yunqingjia/AE-3531-Files/README.md

# AE-3531-Files
Class project for the controls analysis course at Georgia Tech.
