yunqingjia/AE-3531-Files/ControlsProjectStudentTimeline.pdf

### Controls Project Timeline

10/23/18 | Distribute project kits
10/30/18 | Checkpoint 1: Complete PCB and mechanical structure assembly
11/06/18 | Checkpoint 2: Pass Sensor and Serial Plot tests
| Distribute motors and ESCs
11/08/18 | Checkpoint3: Pass ESC and controller tests
11/15/18 | Demo day
11/22/18 | Report due
