yunqingjia/AE-3531-Files/3D Print Files/Dual Motor/Rotating Base.STL

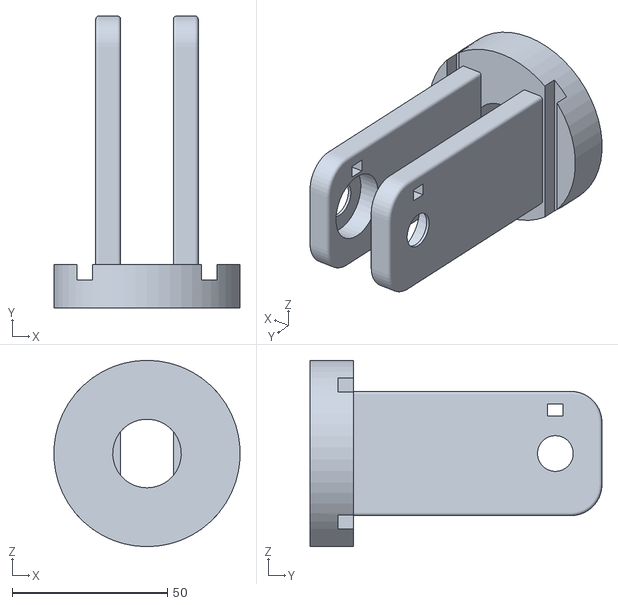
[picture p1: CAD file, 2018-10-11]
3D Print Files/Dual Motor/Rotating Base.STL
59.9 x 94.0 x 60.0
