yunqingjia/AE-3531-Files/3D Print Files/Final Parts for Students/Shaft.STL

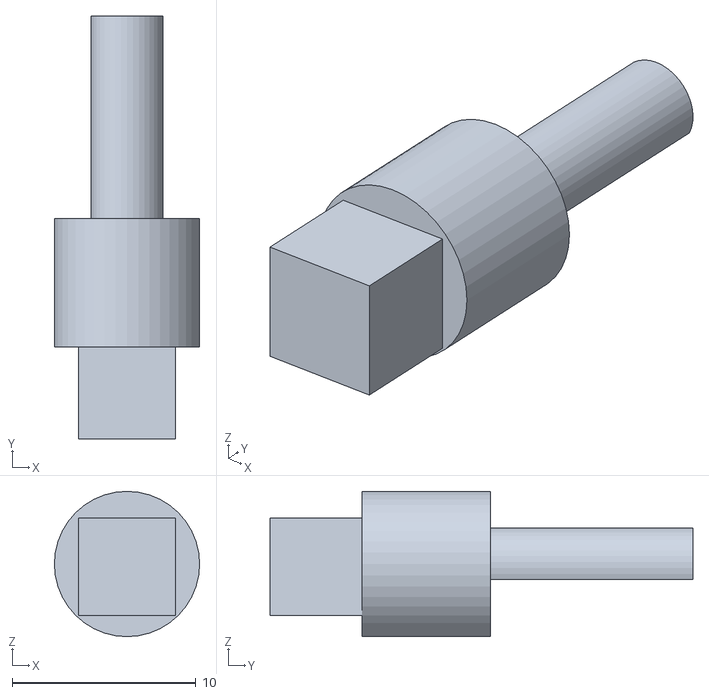
[picture p2: CAD file, 2018-10-11]
3D Print Files/Final Parts for Students/Shaft.STL
7.90 x 23.0 x 7.90
