yunqingjia/AE-3531-Files/3D Print Files/Misc/Fixed Base V2.STL

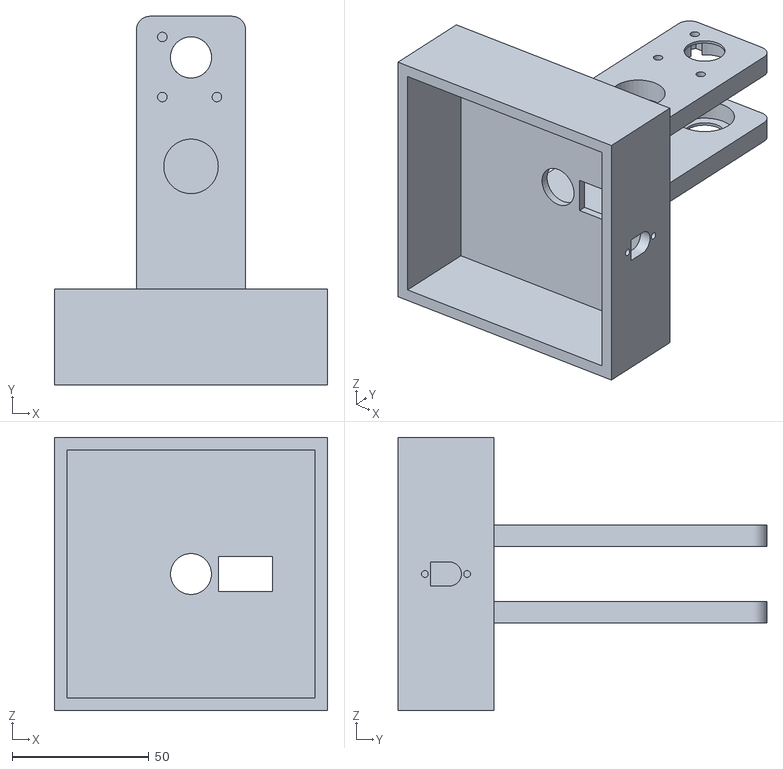
[picture p3: CAD file, 2018-10-11]
3D Print Files/Misc/Fixed Base V2.STL
100.0 x 135.0 x 100.0
