yunqingjia/AE-3531-Files/3D Print Files/Teensy Configuration/Shaft 5.3.STL

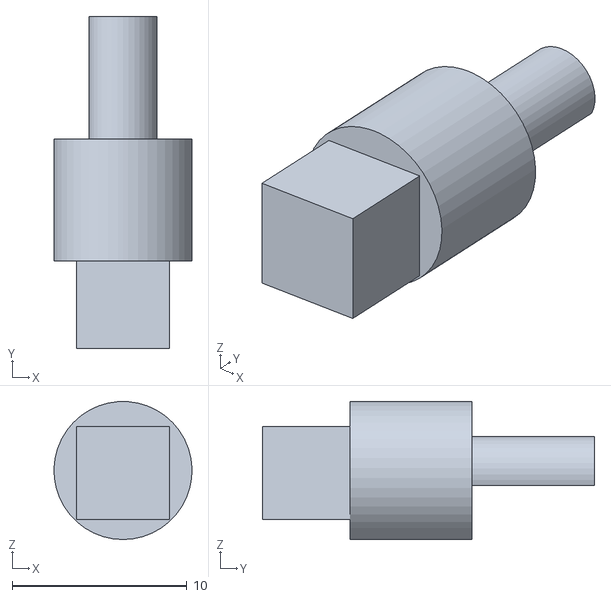
[picture p4: CAD file, 2018-10-11]
3D Print Files/Teensy Configuration/Shaft 5.3.STL
7.89 x 19.0 x 7.90
