yunqingjia/AE-3531-Files/3D Print Files/Dual Motor/Base.STL

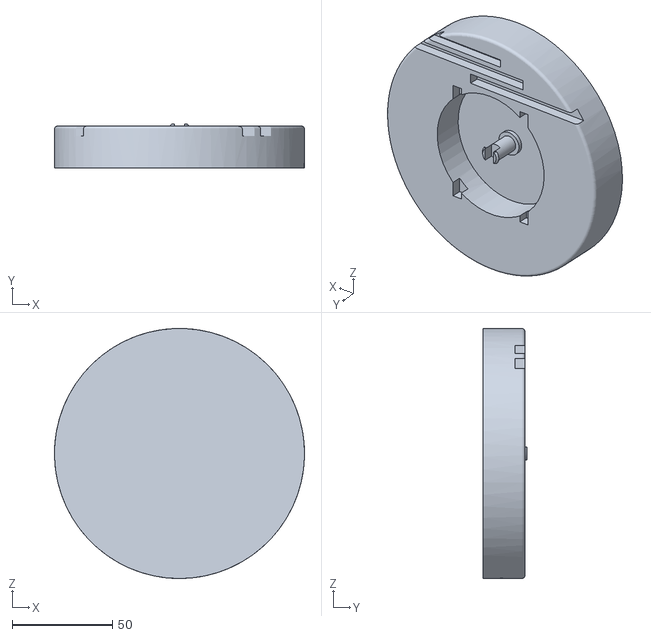
[picture p5: CAD file, 2018-10-11]
3D Print Files/Dual Motor/Base.STL
125.0 x 22.0 x 125.0
