yunqingjia/AE-3531-Files/3D Print Files/Final Parts for Students/Tower.STL

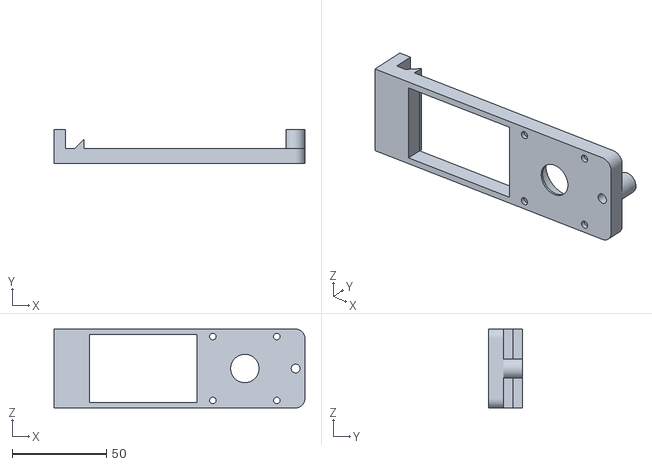
[picture p6: CAD file, 2018-10-11]
3D Print Files/Final Parts for Students/Tower.STL
133.5 x 18.0 x 42.0
