yunqingjia/AE-3531-Files/3D Print Files/Misc/Single Motor Mount.STL

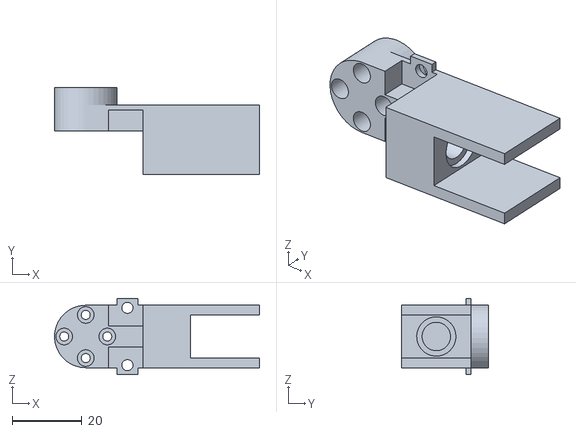
[picture p7: CAD file, 2018-10-11]
3D Print Files/Misc/Single Motor Mount.STL
59.0 x 25.0 x 22.0
