yunqingjia/AE-3531-Files/3D Print Files/Teensy Configuration/FinalBase9.0.STL

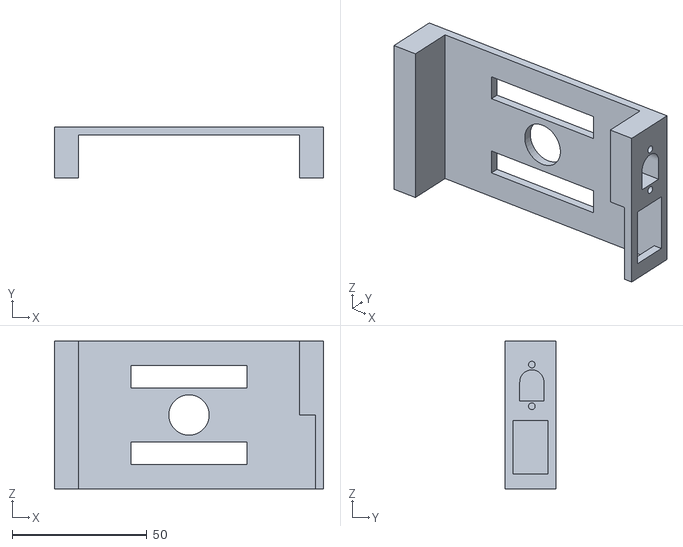
[picture p8: CAD file, 2018-10-11]
3D Print Files/Teensy Configuration/FinalBase9.0.STL
100.0 x 19.0 x 55.0
