yunqingjia/AE-3531-Files/3D Print Files/Dual Motor/Dual Motor Mount.STL

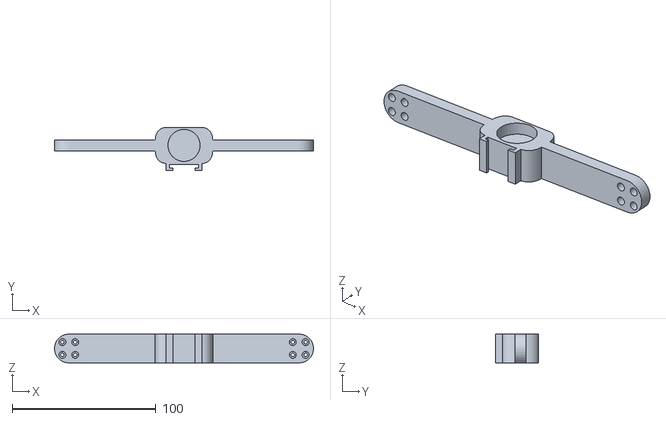
[picture p9: CAD file, 2018-10-11]
3D Print Files/Dual Motor/Dual Motor Mount.STL
179.9 x 30.0 x 20.0
