yunqingjia/AE-3531-Files/3D Print Files/Final Parts for Students/Arm.STL

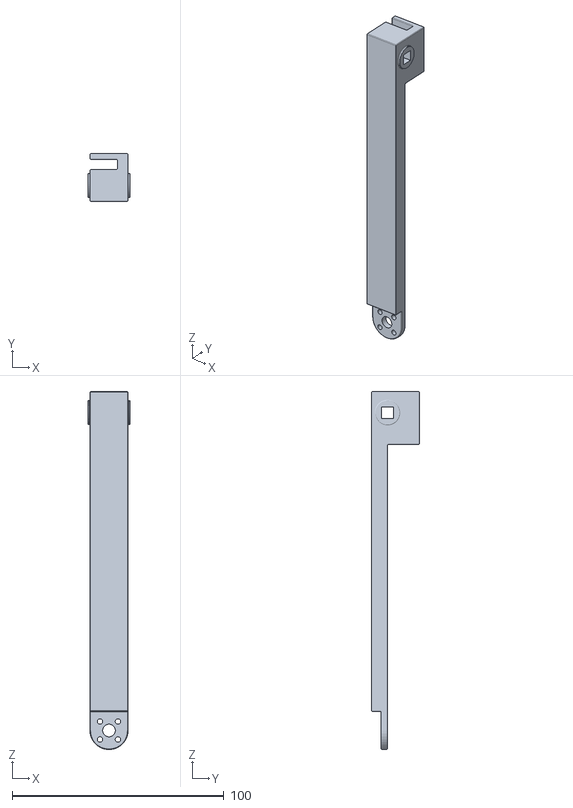
[picture p10: CAD file, 2018-10-11]
3D Print Files/Final Parts for Students/Arm.STL
20.0 x 22.5 x 169.0
