yunqingjia/AE-3531-Files/3D Print Files/Dual Motor/Roll Lock.STL

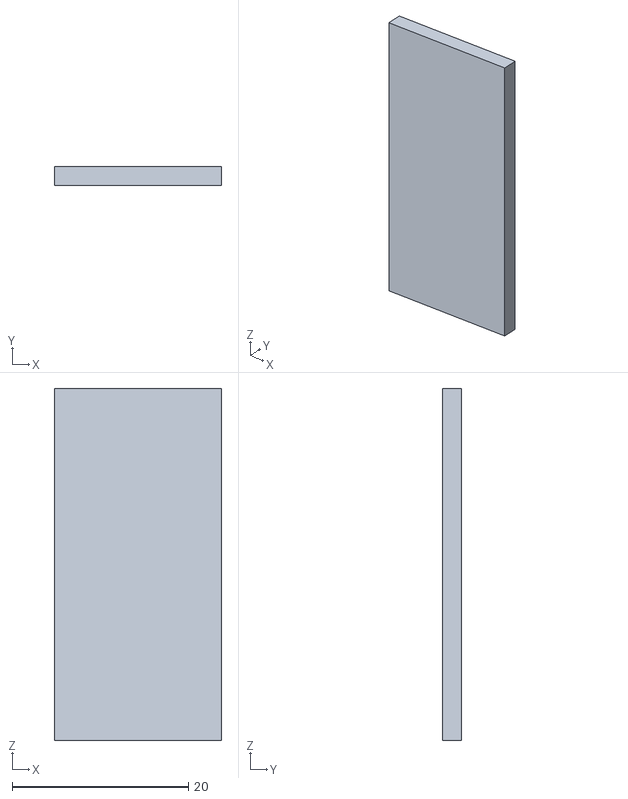
[picture p11: CAD file, 2018-10-11]
3D Print Files/Dual Motor/Roll Lock.STL
19.0 x 2.20 x 40.0
