yunqingjia/AE-3531-Files/3D Print Files/Teensy Configuration/Shaft.STL

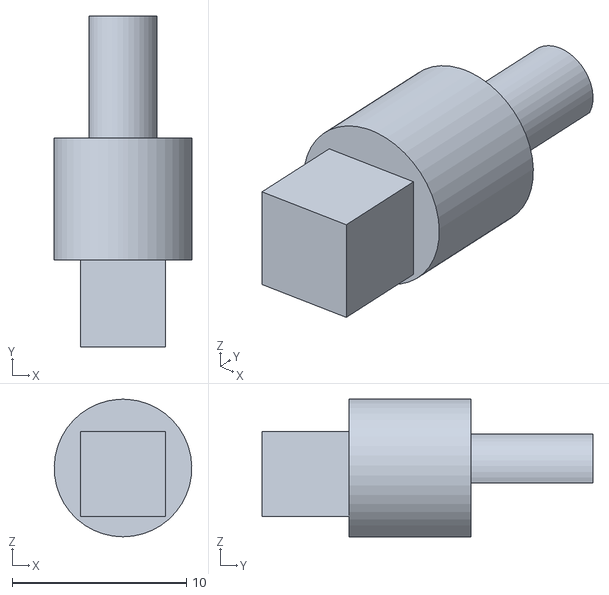
[picture p12: CAD file, 2018-10-11]
3D Print Files/Teensy Configuration/Shaft.STL
7.89 x 19.0 x 7.90
