yunqingjia/AE-3531-Files/3D Print Files/Teensy Configuration/Shaft 5.4 8.0.STL

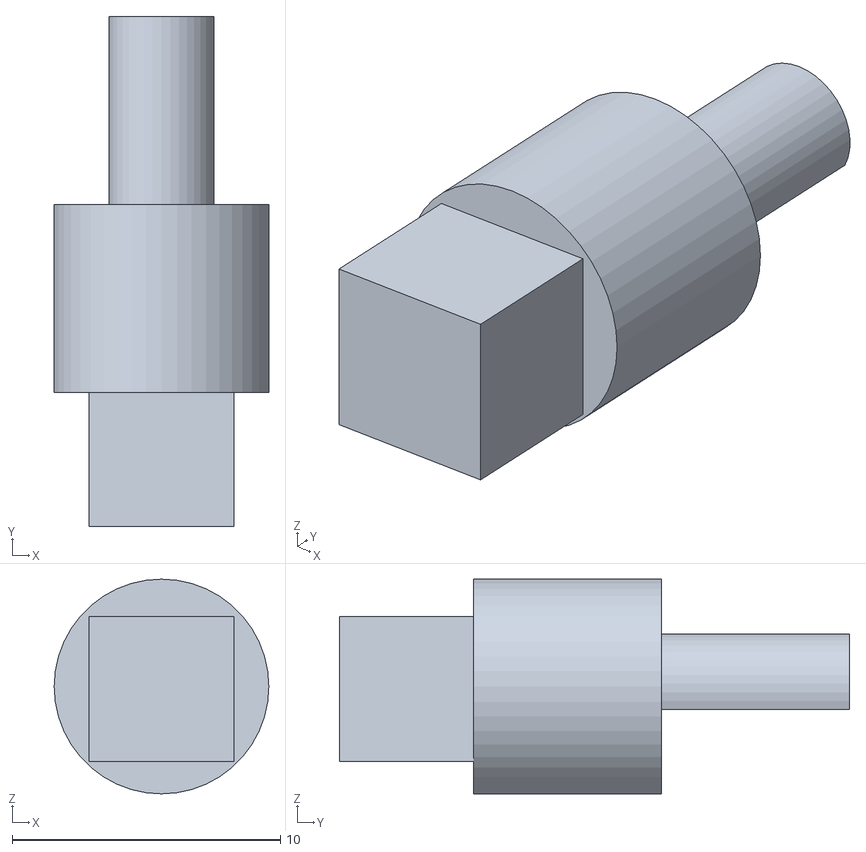
[picture p13: CAD file, 2018-10-11]
3D Print Files/Teensy Configuration/Shaft 5.4 8.0.STL
8.00 x 19.0 x 8.00
