yunqingjia/AE-3531-Files/3D Print Files/Teensy Configuration/Base Without Towers Towers 8.8 Barrel Test.STL

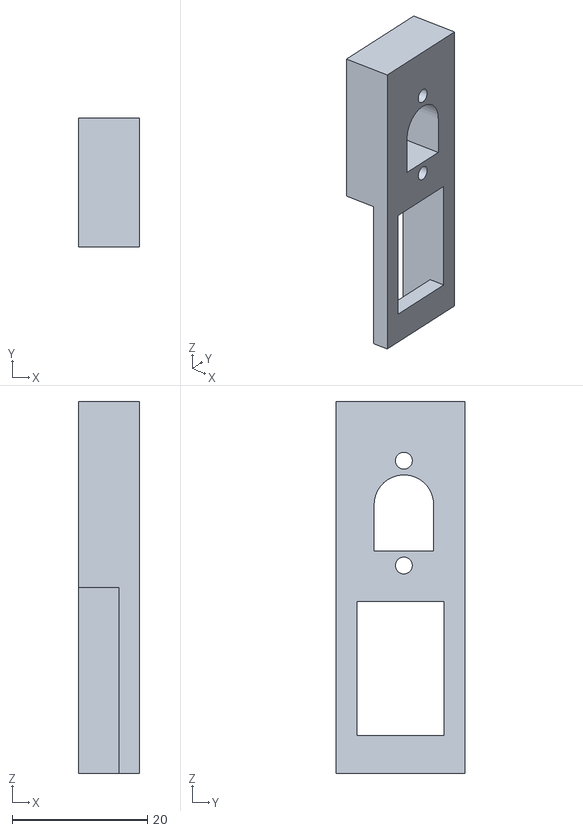
[picture p15: CAD file, 2018-10-11]
3D Print Files/Teensy Configuration/Base Without Towers Towers 8.8 Barrel Test.STL
9.00 x 19.0 x 55.0
