yunqingjia/AE-3531-Files/3D Print Files/Teensy Configuration/Single Motor Arm No Shaft.STL

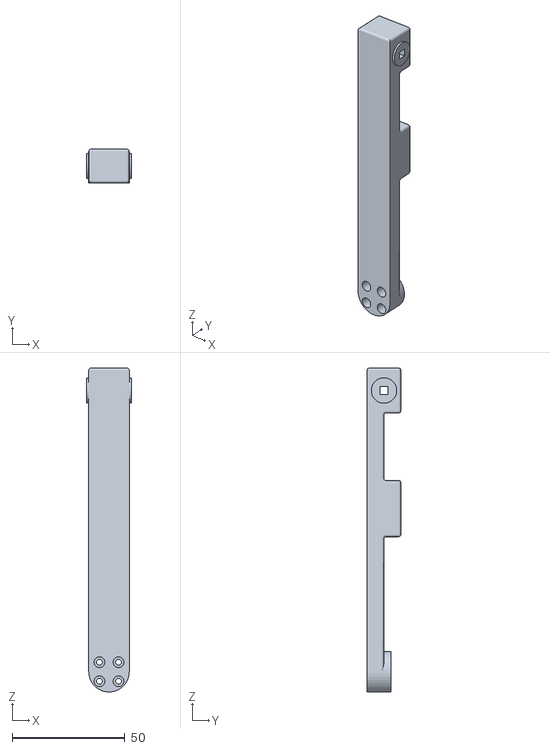
[picture p17: CAD file, 2018-10-11]
3D Print Files/Teensy Configuration/Single Motor Arm No Shaft.STL
20.0 x 15.0 x 144.0
