yunqingjia/AE-3531-Files/3D Print Files/Teensy Configuration/Tower.STL

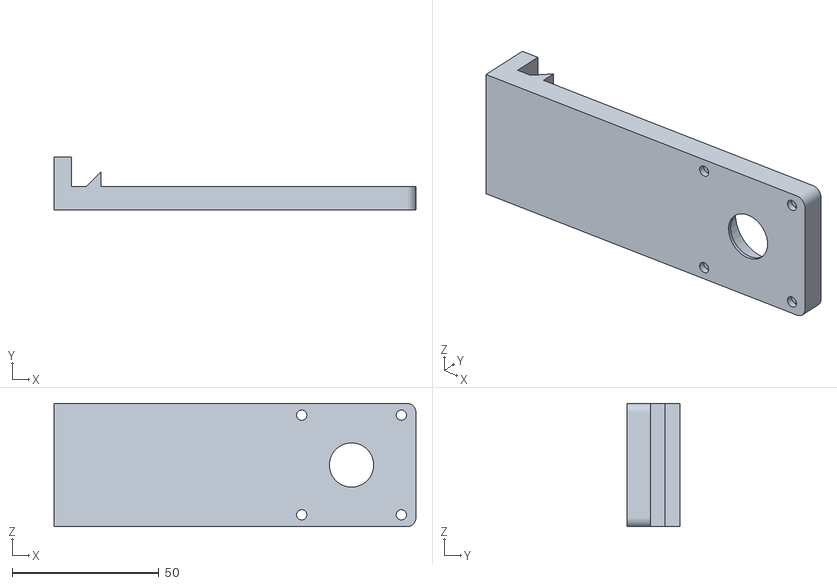
[picture p18: CAD file, 2018-10-11]
3D Print Files/Teensy Configuration/Tower.STL
123.5 x 18.0 x 42.0
