yunqingjia/AE-3531-Files/(list of files, cad)

Other CAD files:
3D Print Files/Teensy Configuration/FinalBase8.9.STL
3D Print Files/Final Parts for Students/Base.STL
3D Print Files/Dual Motor/Arm.STL
3D Print Files/Teensy Configuration/Shaft 5.2.STL
3D Print Files/Teensy Configuration/FinalShaft5.3_7.9_11.STL
3D Print Files/Teensy Configuration/Base Without Towers 9.0 Barrel Test.STL
3D Print Files/Teensy Configuration/Shaft 5.1.STL
3D Print Files/Teensy Configuration/Base Without Towers 8.9 Barrel Test.STL
3D Print Files/Teensy Configuration/Shaft 5.3 8.0.STL
3D Print Files/Teensy Configuration/Shaft 5.0.STL
3D Print Files/Teensy Configuration/Base Without Towers.STL
3D Print Files/Teensy Configuration/Single Motor Arm No Shaft 150mm Center ESC.STL
3D Print Files/Teensy Configuration/Shaft 5.5.STL
3D Print Files/Teensy Configuration/Shaft 5.4.STL
