yunqingjia/AE-3531-Files/EAGLE Files/Arduino Board rev3/Arduino Board rev3.brd

## EAGLE design EAGLE Files/Arduino Board rev3/Arduino Board rev3.brd (2019-02-02)


Parts:
ARDUINO_NANO: ARDUINO_NANO
ESC: M04; 1X04
MOSFET: N-CHANNEL_MOSFETGENERIC; TO-220-SINK
POWER_IN: M02; 1X02
POWER_OUT: M02; 1X02
SENSOR: 10k; SV03A

Connections:
5V: ARDUINO_NANO.5V, SENSOR.3 (A)
12V: POWER_IN.1, POWER_OUT.1
DRIVE: ARDUINO_NANO.D10, MOSFET.1 (G)
ESC: ARDUINO_NANO.D6, ESC.1
GND: ARDUINO_NANO.GND1, MOSFET.3 (S), POWER_IN.2, SENSOR.1 (E)
unnamed: MOSFET.2 (D), POWER_OUT.2
SENSE: ARDUINO_NANO.A0, SENSOR.2 (S), SENSOR.2.1 (S)

Notes on the sheet:
To Barrel Jack
To ESC

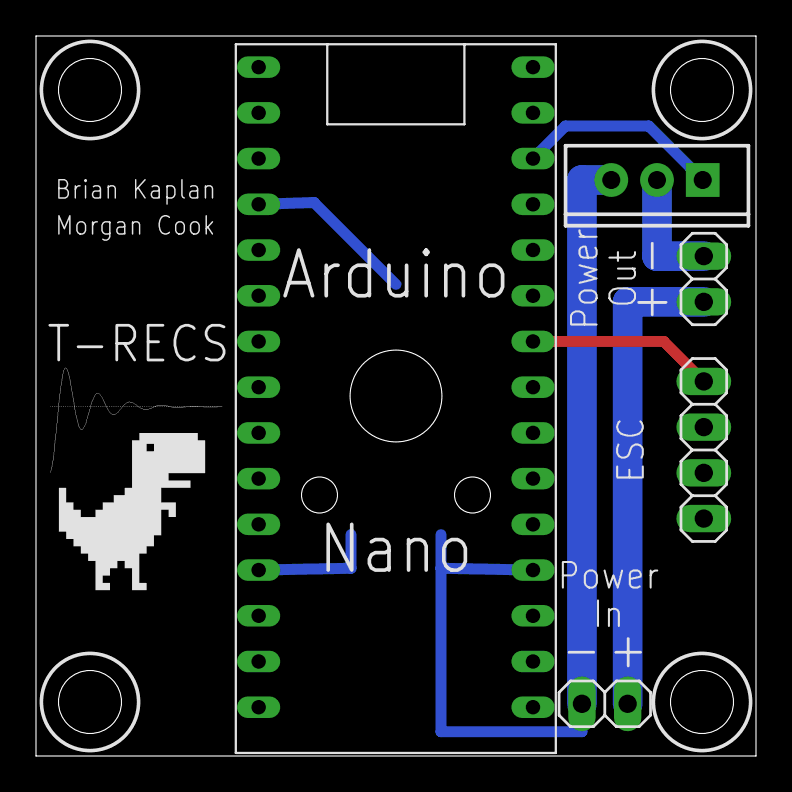
[picture p40: board Arduino Board rev3.brd from above]

Board: 2 copper layers, 40.0 x 40.0 mm, 6 parts (1 on the bottom side), 7 nets.
